Coyseinri/3D-Prints/Seeed Studio ESP32 S3 Xiao with RF433/xiao-s3-rf433-lid.stl

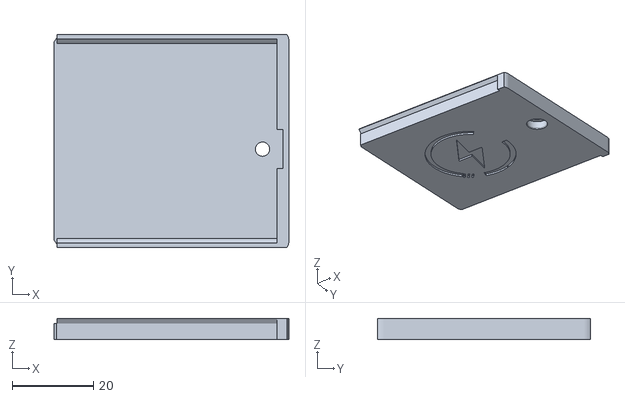
[picture p3: CAD file, 2026-08-26]
Seeed Studio ESP32 S3 Xiao with RF433/xiao-s3-rf433-lid.stl
57.7 x 52.4 x 5.20
