Coyseinri/3D-Prints/Seeed Studio ESP32 S3 Xiao with RF433/xiao-s3-rf433-body.stl

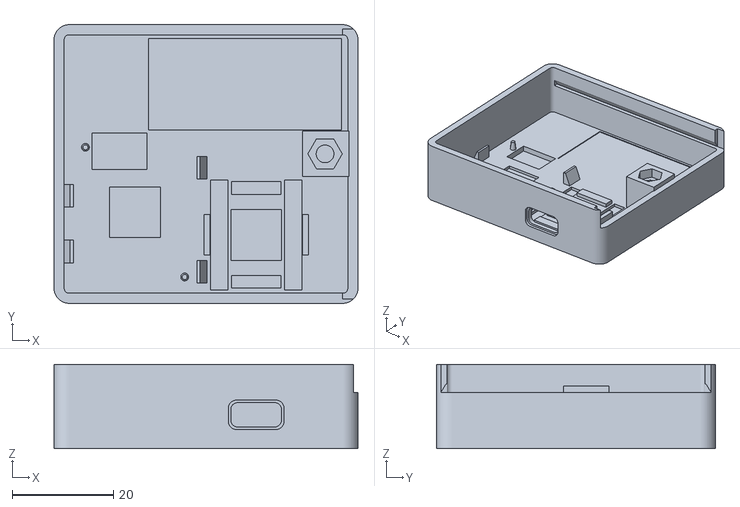
[picture p4: CAD file, 2026-08-26]
Seeed Studio ESP32 S3 Xiao with RF433/xiao-s3-rf433-body.stl
60.0 x 55.0 x 16.6
